IsmailAlrida/amb-processor/docs/report/report.tex

% !TEX root = C:\Users\Alrida Ismail\Documents\GitHub\amb-processor\docs\report\report.tex
\documentclass[12pt,a4paper]{article}

% ============================================================
% PREAMBLE
% ============================================================

% ---------------- Page Geometry ----------------
\usepackage[margin=1in,top=1.4in]{geometry}
\setlength{\headheight}{0.6in}
\setlength{\headsep}{0.3in}

% ---------------- Language ----------------
\usepackage[english]{babel}

% ---------------- Links ----------------
\usepackage[hidelinks]{hyperref}

% ---------------- Core ----------------
\usepackage{graphicx}
\graphicspath{{../../assets/}{./}}
\usepackage{fancyhdr}
\usepackage{xcolor}
\usepackage{titlesec}
\usepackage{float}

% ---------------- Math ----------------
\usepackage{amsmath, amssymb}
\usepackage{siunitx}

% ---------------- Tables ----------------
\usepackage{array, booktabs, tabularx, colortbl}
\newcolumntype{Y}{>{\raggedright\arraybackslash}X}

% ---------------- Code ----------------
\usepackage{listings}
\usepackage{tcolorbox}
\tcbuselibrary{breakable,skins}

\lstset{
    basicstyle=\ttfamily\small,
    breaklines=true,
    columns=fullflexible,
    frame=single
}

% ---------------- Colors ----------------
\definecolor{unired}{HTML}{EB5353}
\definecolor{uniblue}{HTML}{182C44}

% ---------------- Styled Boxes ----------------
\newtcolorbox{resultbox}[1][Key Result]{
    colback=blue!5,
    colframe=uniblue,
    fonttitle=\bfseries,
    title=#1,
    breakable
}

\newtcolorbox{warningbox}[1][Important]{
    colback=red!5,
    colframe=unired,
    fonttitle=\bfseries,
    title=#1,
    breakable
}

\newtcolorbox{tipbox}[1][Design Note]{
    colback=yellow!10,
    colframe=orange!80,
    fonttitle=\bfseries,
    title=#1,
    breakable
}

% ---------------- Header ----------------
\pagestyle{fancy}
\fancyhf{}
\fancyhead[L]{}
\fancyhead[C]{\textbf{\small ELEC 462}}
\fancyhead[R]{\textbf{\footnotesize College of Engineering}}
\fancyfoot[C]{\thepage}

\renewcommand{\headrulewidth}{1.5pt}
\renewcommand{\headrule}{\hbox to\headwidth{\color{unired}\leaders\hrule height \headrulewidth\hfill}}

% ---------------- Section Styling ----------------
\titleformat{\section}{\color{uniblue}\Large\bfseries}{\color{unired}\thesection}{1em}{}

% ============================================================
% TITLE PAGE
% ============================================================

\makeatletter
\renewcommand{\maketitle}{
\begin{titlepage}
\centering



\vspace{1cm}

{\Large United Arab Emirates University\par}
{\large College of Engineering\par}
{\large Department of Electrical Engineering\par}

\vspace{1.8cm}

{\Huge\bfseries\color{uniblue}The AMB Processor\par}
\vspace{0.4cm}
{\Large Implementation and RTL Design of the AMB Processor\par}
\vspace{0.3cm}
{\large Course Project -- Part 2\par}

\vspace{1.5cm}

{\large \textbf{Course:} ELEC 462 -- Computer Architecture and Organization\par}
\vspace{0.5cm}
{\large \textbf{Instructor:} Dr Abulhalim Jallad\par}

\vspace{1.5cm}

\begin{tabular}{|l|l|}
\hline
\textbf{Student Name} & \textbf{Student ID} \\ \hline
Alrida Ismail & 700040283 \\ \hline
Muddathir Yousif & 700039149 \\ \hline
Basel Alhomsi & 700036896 \\ \hline
\end{tabular}

\vfill

{\large \today\par}

\end{titlepage}
}
\makeatother

% ============================================================
\begin{document}
\maketitle

\begin{abstract}
This report presents the AMB processor as a single-cycle implementation of a custom 15-bit instruction set architecture (ISA) with 28-bit data words and byte-addressable memory. The project includes two implementation tracks. The first track preserves the original Part 1 ISA in Logisim artifacts, including the opcode decoder, hardwired control worksheet, and partial datapath. The second track implements the refined processor in Verilog, integrates it with instruction and data memory models, and verifies it through a Python-based assembler and RTL simulation workflow. The Verilog core successfully executes the required array-sum benchmark, producing the value 25 at data-memory address \texttt{0x0200}. The two tracks together show both the course-required control/datapath reasoning and the more regular RTL design that made the processor practical to assemble, simulate, inspect, and explain.
\end{abstract}

\section{ISA Summary}

The AMB processor was designed around a small fixed-length ISA: 15 instruction bits are stored in a 16-bit memory slot, while all architectural data values use 28 bits. Because memory is byte-addressable, every instruction occupies two consecutive bytes and the instruction counter (IC) advances by 2 during sequential execution. The assignment calls this state the program counter (PC); in this report, IC and PC refer to the same fetch address concept.

\begin{table}[H]
\centering
\caption{Core architectural parameters.}
\begin{tabularx}{\linewidth}{|l|Y|}
\hline
\textbf{Item} & \textbf{Value} \\ \hline
Instruction encoding width & 15 bits \\ \hline
Instruction storage width & 16 bits, with bit 15 unused \\ \hline
Data word width & 28 bits \\ \hline
Address width & 28 bits \\ \hline
Instruction memory model & Byte-addressed, two bytes per instruction \\ \hline
Data memory model & Byte-addressed, four bytes per 28-bit word transfer \\ \hline
Sequential IC update & \texttt{IC = IC + 2} \\ \hline
Execution model & Single-cycle fetch, decode, execute, memory, and writeback \\ \hline
\end{tabularx}
\end{table}

The original Part 1 ISA used three instruction formats: a 7-bit opcode register format, a 4-bit jump opcode with an 11-bit immediate, and a 3-bit immediate format. That design met the project constraints, but it forced the control unit to treat each instruction family differently. The refined RTL keeps the same 15-bit storage rule and 28-bit machine width, but regularizes decoding by making \texttt{instr[14:8]} a 7-bit opcode for every implemented instruction.

\begin{table}[H]
\centering
\caption{Implemented register map in the refined RTL path.}
\begin{tabularx}{\linewidth}{|c|l|Y|}
\hline
\textbf{Selector} & \textbf{Name} & \textbf{Role} \\ \hline
\texttt{0000}--\texttt{0111} & R0--R7 & General-purpose registers. \\ \hline
\texttt{1000} & IC (reserved name) & The fetch IC is dedicated CPU state in the RTL; it is exposed to instruction memory and testbenches rather than written as a normal register. \\ \hline
\texttt{1001} & SP & Reserved stack pointer slot. \\ \hline
\texttt{1010} & LC & Reserved loop counter slot. \\ \hline
\texttt{1011} & IMR & Immediate register used to assemble 28-bit constants from four 8-bit immediate-load instructions. \\ \hline
\texttt{1100} & JMPOFF & Base offset for long and conditional jumps. \\ \hline
\texttt{1101} & MEMOFF & Base offset for load/store effective addresses. \\ \hline
\texttt{1110} & CMPA & First operand for conditional branch comparisons. \\ \hline
\texttt{1111} & CMPB & Second operand for conditional branch comparisons. \\ \hline
\end{tabularx}
\end{table}

\begin{tipbox}[IC Implementation Note]
In the first ISA draft, IC appeared as a writable register-file entry. In the refined Verilog implementation, IC is dedicated CPU state. This keeps the fetch path under one synchronous owner while still exposing IC as an output for instruction memory and waveform inspection.
\end{tipbox}

\section{RTL And Logisim Overview}

The project is presented through two complementary implementation tracks. The main processor is the Verilog RTL core, where \texttt{cpu.v} connects instruction fetch, hardwired decode, the register file, the ALU, branch logic, and the external data-memory buses. Around that core, the Python application assembles AMB assembly programs, prepares memory images, launches Icarus Verilog simulation, and opens reports or waveforms. This toolchain is not the processor itself; it is the bench around the processor, and it makes the hardware behavior visible enough to debug.

The Logisim work preserves the original ISA direction requested by the assignment. It includes the opcode decoder, hardwired control-unit table, and partial datapath. That track is useful because it documents the direct course-style design process: signals are labeled, instruction classes are separated, and the control table follows the older instruction formats. The Verilog track then shows the same processor idea after the ISA was cleaned up into a more regular hardware contract.

\begin{resultbox}[Implemented Result]
The RTL simulation executes the mandatory array-sum benchmark for \texttt{N = 5} and array \texttt{[3, 7, 2, 9, 4]}. The recorded validation run halts after 65 cycles, with expected result \texttt{0x19} and actual result \texttt{0x19} at data-memory address \texttt{0x0200}.
\end{resultbox}

\section{ISA Optimization}

\subsection{What Changed}

The most important refinement was making the opcode field constant. In the implemented RTL, every instruction uses \texttt{instr[14:8]} as a 7-bit opcode. Register operations use \texttt{instr[7:4]} as \texttt{Rb} and \texttt{instr[3:0]} as \texttt{Ra}; immediate and jump operations reuse \texttt{instr[7:0]} as an 8-bit immediate. That single decision removes much of the old decoder branching and lets the controller classify operations by direct opcode comparison.

The second refinement was replacing partial destination-register immediate loads with an immediate assembly register, \texttt{IMR}. The processor now uses \texttt{LIL}, \texttt{LIH}, \texttt{LILL}, and \texttt{LIHH} to load four byte lanes of \texttt{IMR}. A normal \texttt{MOV} then transfers the assembled value into a general-purpose or special-purpose register. It takes a few simple instructions, but it avoids a larger immediate datapath and keeps the instruction format tidy.

Memory addressing also changed. The older ISA used \texttt{MEMOFF + imm8} for \texttt{LOAD} and \texttt{STOR}. The implemented RTL uses \texttt{MEMOFF + Rb}. This makes indexed memory access natural: a program can keep a pointer in a register, load or store through it, then increment the pointer using normal ALU instructions. The array-sum benchmark benefits directly from this choice. Table~\ref{tab:format_comparison} shows the encoding shift, while Tables~\ref{tab:old_isa_full} and~\ref{tab:new_isa_full} give the full old and new instruction sets.

\begin{table}[H]
\centering
\caption{Instruction-format change from the original ISA to the RTL-facing ISA.}
\begin{tabularx}{\linewidth}{|l|Y|Y|}
\hline
\textbf{Instruction Class} & \textbf{Original Part 1 Format} & \textbf{Refined RTL Format} \\ \hline
Register and system & \texttt{[14:8] opcode7, [7:4] Ra, [3:0] Rb} & \texttt{[14:8] opcode7, [7:4] Rb, [3:0] Ra} \\ \hline
Jump & \texttt{[14:11] opcode4, [10:0] imm11} & \texttt{[14:8] opcode7, [7:0] imm8} \\ \hline
Immediate and memory & \texttt{[14:12] opcode3, [11:8] Ra, [7:0] imm8} & \texttt{[14:8] opcode7, [7:0] imm8} for immediate loads; \texttt{[14:8] opcode7, [7:4] Rb, [3:0] Ra} for memory. \\ \hline
\end{tabularx}
\label{tab:format_comparison}
\end{table}

\begin{table}[H]
\centering
\small
\caption{Original Part 1 ISA retained for the Logisim compatibility track.}
\begin{tabularx}{\linewidth}{|l|l|l|Y|}
\hline
\textbf{Class} & \textbf{Opcode} & \textbf{Mnemonic} & \textbf{Behavior} \\ \hline
System & \texttt{0000000} & \texttt{HLT} & Halt CPU operation. \\ \hline
System & \texttt{0000001} & \texttt{NOP} & No architectural action. \\ \hline
Register & \texttt{0010000} & \texttt{NOT Ra} & Bitwise inverse of \texttt{Ra} is written to \texttt{Ra}. \\ \hline
Register & \texttt{0010001} & \texttt{OR Ra, Rb} & \texttt{Ra = Ra OR Rb}. \\ \hline
Register & \texttt{0010010} & \texttt{AND Ra, Rb} & \texttt{Ra = Ra AND Rb}. \\ \hline
Register & \texttt{0010011} & \texttt{XOR Ra, Rb} & \texttt{Ra = Ra XOR Rb}. \\ \hline
Register & \texttt{0010100} & \texttt{SHL Ra} & \texttt{Ra = Ra} $\ll$ \texttt{SHC}. \\ \hline
Register & \texttt{0010101} & \texttt{SHR Ra} & \texttt{Ra = Ra} $\gg$ \texttt{SHC}. \\ \hline
Register & \texttt{0010110} & \texttt{SAR Ra} & Arithmetic right shift of \texttt{Ra} by \texttt{SHC}. \\ \hline
Register & \texttt{0010111} & \texttt{ADD Ra, Rb} & \texttt{Ra = Ra + Rb}. \\ \hline
Register & \texttt{0011000} & \texttt{SUB Ra, Rb} & \texttt{Ra = Ra - Rb}. \\ \hline
Register & \texttt{0011001} & \texttt{MOV Ra, Rb} & \texttt{Ra = Rb}. \\ \hline
Jump & \texttt{0100} & \texttt{JMP imm11} & $\mathrm{IC} = \mathrm{IC} + (\mathrm{imm11} \ll 1)$. \\ \hline
Jump & \texttt{0101} & \texttt{JMPL imm11} & $\mathrm{IC} = \mathrm{IC} + (\mathrm{imm11} \ll 1) + \mathrm{JMPOFF}$. \\ \hline
Jump & \texttt{0110} & \texttt{JPEQ imm11} & If \texttt{CMPA == CMPB}, execute the long-jump update. \\ \hline
Jump & \texttt{0111} & \texttt{JPBLW imm11} & If \texttt{CMPA} $<$ \texttt{CMPB}, execute the long-jump update. \\ \hline
Immediate & \texttt{100} & \texttt{LIL Ra, imm8} & Set \texttt{Ra[7:0] = imm8}. \\ \hline
Immediate & \texttt{101} & \texttt{LIH Ra, imm8} & Set \texttt{Ra[15:8] = imm8}. \\ \hline
Immediate & \texttt{110} & \texttt{LOAD Ra, imm8} & \texttt{Ra = MEM[imm8 + MEMOFF]} as a 28-bit word. \\ \hline
Immediate & \texttt{111} & \texttt{STOR Ra, imm8} & \texttt{MEM[imm8 + MEMOFF] = Ra} as a 28-bit word. \\ \hline
\end{tabularx}
\label{tab:old_isa_full}
\end{table}

In the original register map, selector \texttt{1011} was \texttt{SHC}, the shift-count register used by \texttt{SHL}, \texttt{SHR}, and \texttt{SAR}. In the refined RTL map, that slot becomes \texttt{IMR}, and shifts use the normal \texttt{Rb} source register. That is a small ISA change, but it removes a special operand path from the ALU side of the datapath.

\begin{table}[H]
\centering
\small
\caption{Refined ISA implemented by the Verilog RTL.}
\begin{tabularx}{\linewidth}{|l|l|Y|}
\hline
\textbf{Opcode7} & \textbf{Mnemonic} & \textbf{Implemented Behavior} \\ \hline
\texttt{0000000} & \texttt{HLT} & Halt CPU operation and freeze state updates. \\ \hline
\texttt{0000001} & \texttt{NOP} & No architectural action; normal IC update still applies. \\ \hline
\texttt{0010000} & \texttt{NOT Ra} & Bitwise inverse of \texttt{Ra} is written to \texttt{Ra}. \\ \hline
\texttt{0010001} & \texttt{OR Ra, Rb} & \texttt{Ra = Ra OR Rb}. \\ \hline
\texttt{0010010} & \texttt{AND Ra, Rb} & \texttt{Ra = Ra AND Rb}. \\ \hline
\texttt{0010011} & \texttt{XOR Ra, Rb} & \texttt{Ra = Ra XOR Rb}. \\ \hline
\texttt{0010100} & \texttt{SHL Ra, Rb} & \texttt{Ra = Ra} $\ll$ \texttt{Rb}. \\ \hline
\texttt{0010101} & \texttt{SHR Ra, Rb} & \texttt{Ra = Ra} $\gg$ \texttt{Rb}. \\ \hline
\texttt{0010110} & \texttt{SAR Ra, Rb} & Arithmetic right shift of \texttt{Ra} by \texttt{Rb}. \\ \hline
\texttt{0010111} & \texttt{ADD Ra, Rb} & \texttt{Ra = Ra + Rb}. \\ \hline
\texttt{0011000} & \texttt{SUB Ra, Rb} & \texttt{Ra = Ra - Rb}. \\ \hline
\texttt{0011001} & \texttt{MOV Ra, Rb} & \texttt{Ra = Rb}. \\ \hline
\texttt{0011010} & \texttt{LIL imm8} & Set \texttt{IMR[7:0] = imm8}. \\ \hline
\texttt{0011011} & \texttt{LIH imm8} & Set \texttt{IMR[15:8] = imm8}. \\ \hline
\texttt{0011100} & \texttt{LILL imm8} & Set \texttt{IMR[23:16] = imm8}. \\ \hline
\texttt{0011101} & \texttt{LIHH imm8} & Set \texttt{IMR[27:24] = imm8[3:0]}. \\ \hline
\texttt{0011110} & \texttt{LOAD Ra, Rb} & \texttt{Ra = MEM[Rb + MEMOFF]} as a 28-bit word. \\ \hline
\texttt{0011111} & \texttt{STOR Ra, Rb} & \texttt{MEM[Rb + MEMOFF] = Ra} as a 28-bit word. \\ \hline
\texttt{1000000} & \texttt{JMP imm8} & $\mathrm{IC} = \mathrm{IC} + (\operatorname{signext}(\mathrm{imm8}) \ll 1)$. \\ \hline
\texttt{1000001} & \texttt{JMPL imm8} & $\mathrm{IC} = \mathrm{IC} + ((\operatorname{signext}(\mathrm{imm8}) + \mathrm{JMPOFF}) \ll 1)$. \\ \hline
\texttt{1000010} & \texttt{JPEQ imm8} & If \texttt{CMPA == CMPB}, execute the long-jump update. \\ \hline
\texttt{1000011} & \texttt{JPBLW imm8} & If \texttt{CMPA} $<$ \texttt{CMPB}, execute the long-jump update. \\ \hline
\end{tabularx}
\label{tab:new_isa_full}
\end{table}

\subsection{Why The Refinement Helped}

The original ISA was compact, but compactness came with control cost. A mixed opcode field means the control unit must first identify the instruction family and only then interpret the remaining bits. That is manageable on paper, but in a single-cycle datapath it quickly adds multiplexers, special cases, and decode paths that are easy to wire incorrectly.

The refined ISA trades a little encoding density for a cleaner datapath. With one opcode field, instruction classification becomes a direct comparison. With \texttt{IMR}, constant construction is explicit and easy to trace. With register-indexed memory, the benchmark loop can walk through an array using ordinary pointer arithmetic. In short, the new ISA is still small, but it gives the hardware fewer ways to get tangled.

\section{Datapath And RTL Development}

The Verilog processor is a single-cycle datapath. Instruction memory provides the current instruction combinationally from \texttt{IC}; the controller decodes \texttt{opcode}; the register file exposes \texttt{Ra} and \texttt{Rb}; the ALU produces arithmetic, logical, comparison, or address results; and the selected writeback value is committed on the next rising clock edge.

The instruction counter is one of the few explicitly synchronous elements in the core. On reset, \texttt{IC} becomes zero. When \texttt{halt} is not asserted, the next clock edge loads either \texttt{IC + 2} or the branch target:
\[
\mathrm{NextIC} = \mathrm{IC} +
\begin{cases}
(\operatorname{signext}(\mathrm{imm8}) + \mathrm{JMPOFF}) \ll 1, & \text{long or conditional jump taken} \\
\operatorname{signext}(\mathrm{imm8}) \ll 1, & \text{plain jump taken} \\
2, & \text{sequential execution.}
\end{cases}
\]
The left shift by one converts an instruction offset into a byte offset because each instruction occupies two bytes.

The register file uses asynchronous reads and synchronous writes. This is well suited to a single-cycle teaching processor: source operands are visible during the cycle, and the result lands in the destination register only at the clock edge. The same writeback port handles ALU results, memory loads, and immediate-byte writes into \texttt{IMR}. For \texttt{IMR}, the \texttt{ImmSel} control signal selects which byte lane is updated.

The data memory is byte-addressed but transfers 28-bit words. Reads are asynchronous and return four bytes assembled little-endian, with the upper nibble of the fourth byte used for bits 27--24. Stores are synchronous and split a 28-bit value back across four byte locations. This is why the benchmark uses a stride of 4 when iterating over the array.

\begin{table}[H]
\centering
\caption{Main datapath signals in the RTL core.}
\begin{tabularx}{\linewidth}{|l|Y|}
\hline
\textbf{Signal} & \textbf{Role} \\ \hline
\texttt{IC} & Byte address of the instruction currently being fetched. \\ \hline
\texttt{instr} & 16-bit stored instruction word; \texttt{instr[14:0]} is the ISA instruction. \\ \hline
\texttt{ReadDataRa}, \texttt{ReadDataRb} & Register-file outputs selected by the decoded instruction fields or by \texttt{CMPA}/\texttt{CMPB} during branches. \\ \hline
\texttt{OperandA}, \texttt{OperandB} & ALU operands; memory operations force \texttt{OperandA = MEMOFF}. \\ \hline
\texttt{ALURes} & Shared ALU output used for register writeback, data-memory address generation, and comparison side effects. \\ \hline
\texttt{DataAddress} & External data-memory address, directly driven by \texttt{ALURes}. \\ \hline
\texttt{RegDataWrite} & Final value written to the register file, selected from memory, ALU, immediate data, or zero. \\ \hline
\end{tabularx}
\end{table}

\section{Control Unit And Control Table}

The implemented controller is hardwired and combinational. It does not store microinstructions or step through states; each opcode directly produces the control signals needed for that cycle. This matches the single-cycle datapath: all control decisions are made before the clock edge that updates \texttt{IC}, the register file, and data memory.

\begin{table}[H]
\centering
\scriptsize
\caption{Verilog control table extracted from the implemented controller. \texttt{X} indicates a don't-care value because the destination path is disabled or unused.}
\resizebox{\linewidth}{!}{%
\begin{tabular}{lccccccccccccc}
\toprule
\textbf{Instr.} & \textbf{MemOp} & \textbf{RegWrite} & \textbf{ReadEn} & \textbf{WriteEn} & \textbf{isJump} & \textbf{LongJump} & \textbf{BrEq} & \textbf{BrLt} & \textbf{ImmLoad} & \textbf{RegDest} & \textbf{ImmSel} & \textbf{ALUCtrl} & \textbf{halt} \\
\midrule
\texttt{HLT}   & 0 & 0 & 0 & 0 & 0 & 0 & 0 & 0 & 0 & X  & X  & X    & 1 \\
\texttt{NOP}   & 0 & 0 & 0 & 0 & 0 & 0 & 0 & 0 & 0 & X  & X  & X    & 0 \\
\texttt{NOT}   & 0 & 1 & 0 & 0 & 0 & 0 & 0 & 0 & 0 & 01 & X  & 0000 & 0 \\
\texttt{OR}    & 0 & 1 & 0 & 0 & 0 & 0 & 0 & 0 & 0 & 01 & X  & 0001 & 0 \\
\texttt{AND}   & 0 & 1 & 0 & 0 & 0 & 0 & 0 & 0 & 0 & 01 & X  & 0010 & 0 \\
\texttt{XOR}   & 0 & 1 & 0 & 0 & 0 & 0 & 0 & 0 & 0 & 01 & X  & 0011 & 0 \\
\texttt{SHL}   & 0 & 1 & 0 & 0 & 0 & 0 & 0 & 0 & 0 & 01 & X  & 0100 & 0 \\
\texttt{SHR}   & 0 & 1 & 0 & 0 & 0 & 0 & 0 & 0 & 0 & 01 & X  & 0101 & 0 \\
\texttt{SAR}   & 0 & 1 & 0 & 0 & 0 & 0 & 0 & 0 & 0 & 01 & X  & 0110 & 0 \\
\texttt{ADD}   & 0 & 1 & 0 & 0 & 0 & 0 & 0 & 0 & 0 & 01 & X  & 0111 & 0 \\
\texttt{SUB}   & 0 & 1 & 0 & 0 & 0 & 0 & 0 & 0 & 0 & 01 & X  & 1000 & 0 \\
\texttt{MOV}   & 0 & 1 & 0 & 0 & 0 & 0 & 0 & 0 & 0 & 01 & X  & 1001 & 0 \\
\texttt{LIL}   & 0 & 1 & 0 & 0 & 0 & 0 & 0 & 0 & 1 & 10 & 00 & X    & 0 \\
\texttt{LIH}   & 0 & 1 & 0 & 0 & 0 & 0 & 0 & 0 & 1 & 10 & 01 & X    & 0 \\
\texttt{LILL}  & 0 & 1 & 0 & 0 & 0 & 0 & 0 & 0 & 1 & 10 & 10 & X    & 0 \\
\texttt{LIHH}  & 0 & 1 & 0 & 0 & 0 & 0 & 0 & 0 & 1 & 10 & 11 & X    & 0 \\
\texttt{LOAD}  & 1 & 1 & 1 & 0 & 0 & 0 & 0 & 0 & 0 & 00 & X  & 0111 & 0 \\
\texttt{STOR}  & 1 & 0 & 0 & 1 & 0 & 0 & 0 & 0 & 0 & X  & X  & 0111 & 0 \\
\texttt{JMP}   & 0 & 0 & 0 & 0 & 1 & 0 & 0 & 0 & 0 & X  & X  & X    & 0 \\
\texttt{JMPL}  & 0 & 0 & 0 & 0 & 1 & 1 & 0 & 0 & 0 & X  & X  & X    & 0 \\
\texttt{JPEQ}  & 0 & 0 & 0 & 0 & 1 & 1 & 1 & 0 & 0 & X  & X  & 1000 & 0 \\
\texttt{JPBLW} & 0 & 0 & 0 & 0 & 1 & 1 & 0 & 1 & 0 & X  & X  & 1000 & 0 \\
\bottomrule
\end{tabular}}
\label{tab:rtl_control}
\end{table}

\noindent The writeback selector is encoded as \texttt{RegDest = 00} for data memory, \texttt{01} for ALU result, and \texttt{10} for the zero-extended immediate byte. The \texttt{ImmSel} field selects the \texttt{IMR} byte lane: \texttt{00} for bits 7--0, \texttt{01} for bits 15--8, \texttt{10} for bits 23--16, and \texttt{11} for bits 27--24.

Branch control is deliberately explicit. For \texttt{JPEQ} and \texttt{JPBLW}, the CPU overrides the normal instruction register selects and reads \texttt{CMPA} and \texttt{CMPB}. The ALU continuously computes equality and unsigned less-than flags, and the branch unit selects the next IC only when the selected condition is true. This avoids hidden condition-code state and makes branch behavior easy to see in a waveform.

\section{Instruction Execution And Benchmark}

The mandatory benchmark sums five words from memory:
\[
3 + 7 + 2 + 9 + 4 = 25 = \texttt{0x19}.
\]
The data layout follows the assignment prompt: \texttt{LEN} is stored at \texttt{0x0100}, the array begins at \texttt{0x0104}, and the result is written to \texttt{0x0200}. Since each AMB data word occupies four bytes in the byte-addressed data memory, the loop increments the array pointer by 4 after every load. Listing~\ref{lst:array_sum_source} is the same benchmark source loaded by the app through its sample-code path.

\begin{lstlisting}[caption={Array-sum benchmark assembly source loaded by the app.},label={lst:array_sum_source}]
// Array sum benchmark
// N = 5
// ARRAY = [3, 7, 2, 9, 4]
// RESULT should become 25 at address 0x0200.

// R0 = sum
// R1 = LEN pointer
// R2 = len
// R3 = index
// R4 = 1
// R5 = 4-byte word stride
// R6 = array/result pointer
// R7 = current element

// Load LEN into R2
LIL 0x00
LIH 0x01
MOV R1, IMR
LOAD R2, R1

// Intialize sum and index registers as 0
LIL 0x00
LIH 0x00
MOV R0, IMR
MOV R3, IMR

// Set R4[0]
LIL 0x01
LIH 0x00
MOV R4, IMR

// R5 as 4 to use for striding 4-bytes in memory
LIL 0x04
LIH 0x00
MOV R5, IMR

// Load array start location to R6
LIL 0x04
LIH 0x01
MOV R6, IMR

// Loop across
loop:
MOV CMPA, R3
MOV CMPB, R2
JPBLW body
JMP done

// Loop while the index is less than the length
body:
LOAD R7, R6
ADD R0, R7

// Stride forward
ADD R6, R5

// Increment loop counter
ADD R3, R4

// Repeat
JMP loop

// Finish when index (R3) == len (R2)
done:
LIL 0x00
LIH 0x02
MOV R6, IMR
STOR R0, R6
HLT
\end{lstlisting}

The program first builds the required constants through \texttt{IMR}, then copies them into working registers. The loop uses \texttt{R0} as the running sum, \texttt{R2} as the length, \texttt{R3} as the index, \texttt{R5} as the four-byte stride, \texttt{R6} as the data pointer, and \texttt{R7} as the current element. Before each conditional branch, \texttt{R3} and \texttt{R2} are moved into \texttt{CMPA} and \texttt{CMPB}; \texttt{JPBLW} continues the loop while the index is below the length.

\begin{figure}[H]
\centering
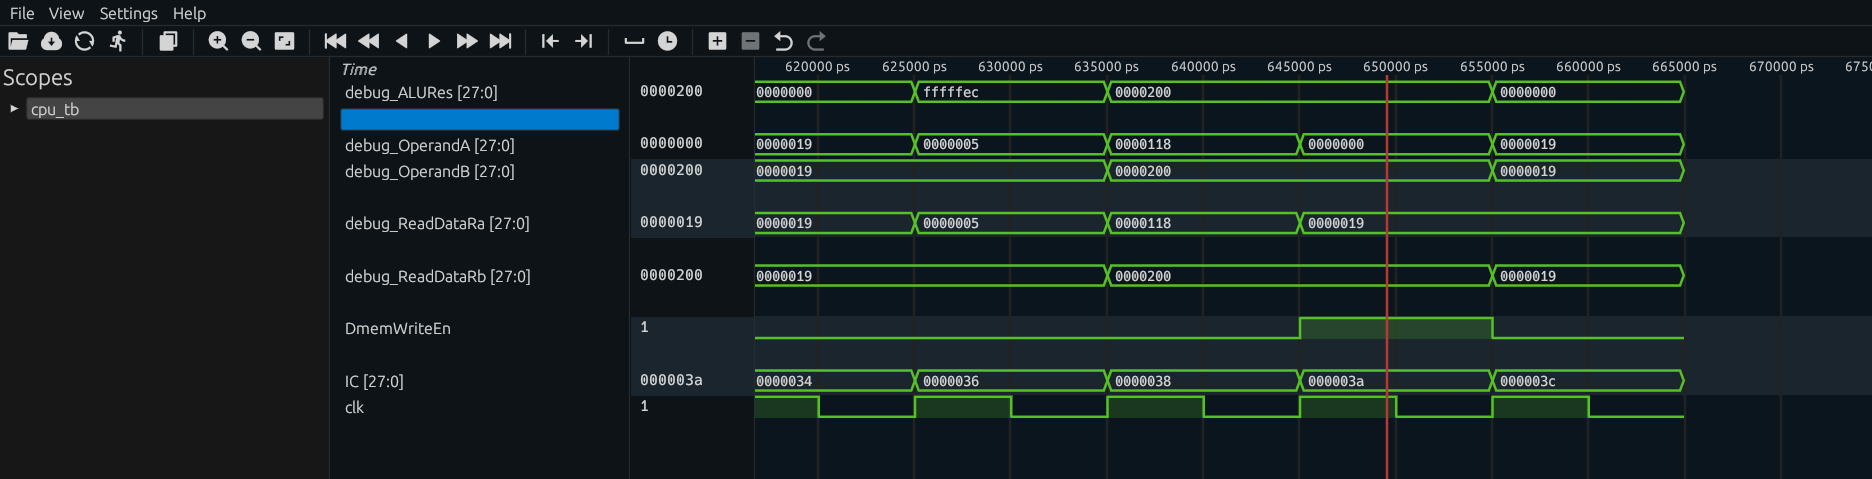
[picture p5: docs/report/writing0x19(Rb)to0x200(alures)dmem.png]

\caption{RTL waveform capture showing the final store of \texttt{0x19} to result address \texttt{0x0200}.}
\label{fig:rtl_result_waveform}
\end{figure}

Figure~\ref{fig:rtl_result_waveform} shows the final store transaction. In this cycle, \texttt{STOR R0, R6} uses \texttt{R0} as the value source and \texttt{R6} as the address source. Because \texttt{MEMOFF} is zero for this benchmark, the ALU address calculation is \texttt{0 + 0x0200}. The ALU result therefore drives \texttt{DataAddress = 0x0200}, while the data-memory write bus carries \texttt{0x19}. The value is committed only when \texttt{DmemWriteEn} is asserted.

\section{Integrated App Workflow}

The Python application exists to make the RTL processor easier to use, not to replace it. It provides an editor for AMB assembly, assembles source code into instruction-memory hex, prepares data-memory images, runs the Verilog testbench, and opens the generated result summary and waveform files. The app can be installed from the project \href{https://github.com/IsmailAlrida/amb-processor/releases/tag/latest}{GitHub releases page}.

To reproduce the benchmark, open the app, load the sample code, select the array-sum benchmark, and assemble the program. The sample also preloads the data memory with the required benchmark data, so the assembly program can focus on the processor behavior rather than manually constructing the array. After assembly, running the RTL simulation launches the Verilog testbench in the background and produces a report containing the final result, cycle count, halt status, and generated waveform artifacts.

For deeper inspection, the waveform viewer exposes the same internal signals used in this report: \texttt{IC}, \texttt{instr}, \texttt{opcode}, \texttt{RegWrite}, \texttt{RegDest}, data-memory enables, \texttt{DataAddress}, ALU operands, ALU result, comparison flags, and branch decisions. This gives the demonstration a useful split: the app shows that the program works, and the waveform shows why it works.

\section{Work-in-progress Logisim CPU}

The Logisim implementation follows the original Part 1 ISA and assignment-style control signals. Its purpose is to document the direct single-cycle datapath design requested in the project prompt: PC, instruction memory, register file, ALU, data memory, immediate unit, multiplexers, and hardwired control. The opcode decoder and control unit were built, while the full datapath remained a work in progress.

\begin{figure}[H]
\centering

\caption{Opcode decoder developed for the original Logisim ISA path.}
\label{fig:logisim_opcode_decoder}
\end{figure}

\begin{figure}[H]
\centering
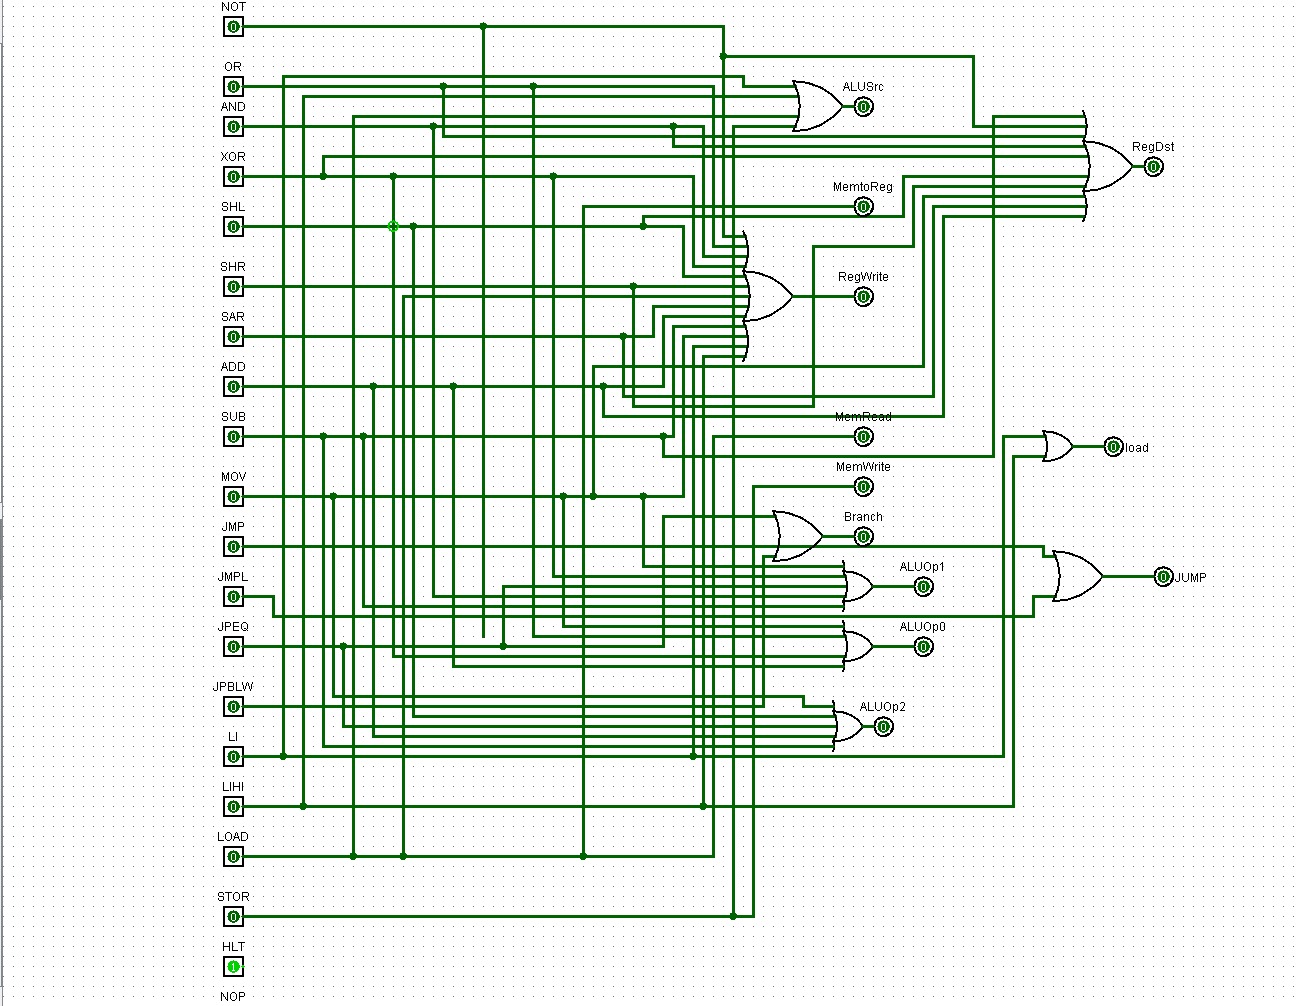
[picture p6: docs/report/logisim_control_unit.jpeg]

\caption{Logisim control-unit wiring for the original control signal set.}
\label{fig:logisim_control_unit}
\end{figure}

\begin{figure}[H]
\centering
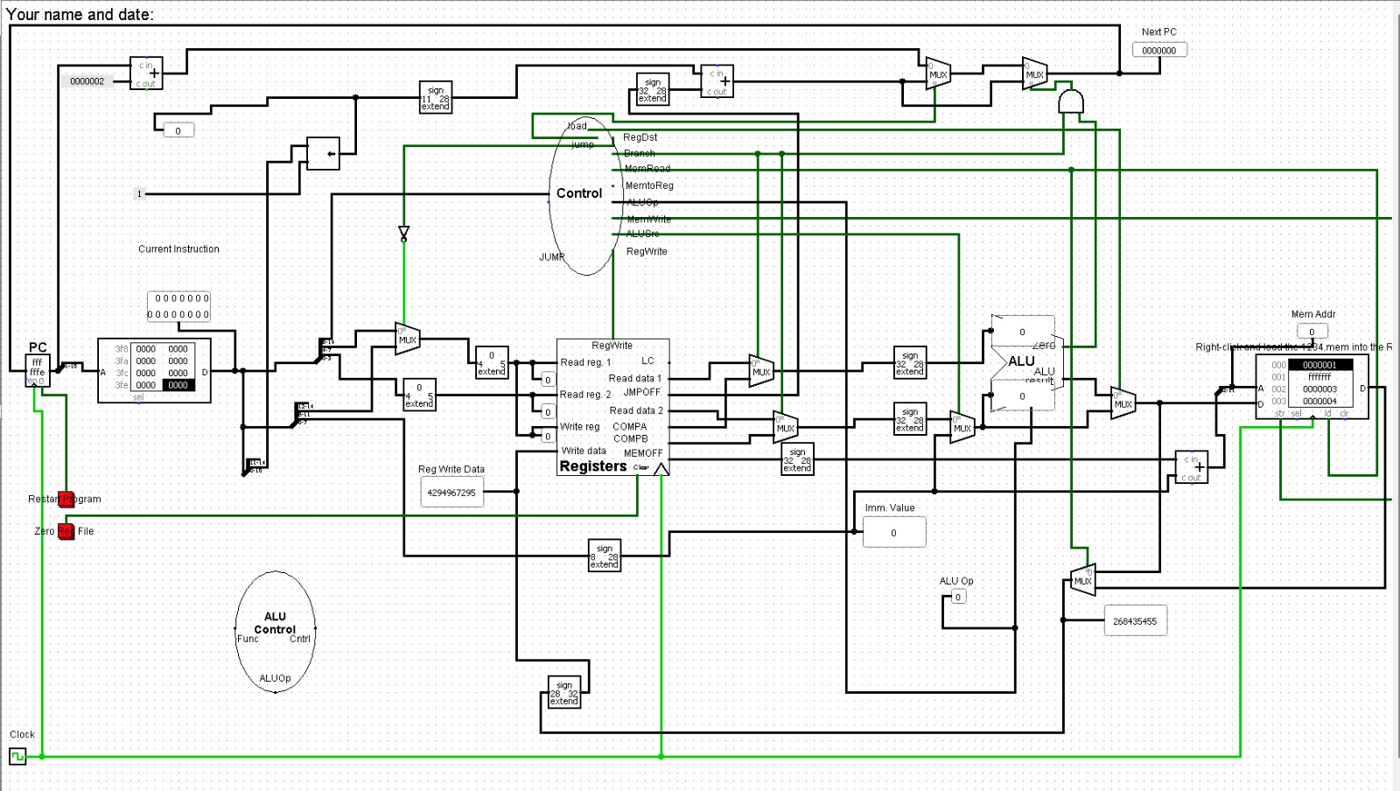
[picture p7: docs/report/partial-logisim-datapath.jpeg]

\caption{Partial Logisim datapath showing the course-required hardware construction direction.}
\label{fig:partial_logisim_datapath}
\end{figure}

The legacy control table used a compact control vocabulary: \texttt{RegWrite}, \texttt{MemRead}, \texttt{MemWrite}, \texttt{ALUSrc}, \texttt{Jump}, \texttt{Branch}, and \texttt{ALUOp}. This table is different from the Verilog controller in Table~\ref{tab:rtl_control}; it belongs to the original mixed-format ISA, where immediate and jump instructions required separate decoding rules.

\begin{table}[H]
\centering
\scriptsize
\caption{Legacy Logisim control-unit table transcribed from the control decoding worksheet.}
\resizebox{\linewidth}{!}{%
\begin{tabular}{llccccccc}
\toprule
\textbf{Instr.} & \textbf{Type} & \textbf{RegWrite} & \textbf{MemRead} & \textbf{MemWrite} & \textbf{ALUSrc} & \textbf{Jump} & \textbf{Branch} & \textbf{ALUOp} \\
\midrule
\texttt{ADD} & R & 1 & 0 & 0 & 0 & 0 & 0 & ADD \\
\texttt{SUB} & R & 1 & 0 & 0 & 0 & 0 & 0 & SUB \\
\texttt{AND} & R & 1 & 0 & 0 & 0 & 0 & 0 & AND \\
\texttt{OR}  & R & 1 & 0 & 0 & 0 & 0 & 0 & OR \\
\texttt{XOR} & R & 1 & 0 & 0 & 0 & 0 & 0 & XOR \\
\texttt{SHL} & R & 1 & 0 & 0 & 0 & 0 & 0 & SHL \\
\texttt{SHR} & R & 1 & 0 & 0 & 0 & 0 & 0 & SHR \\
\texttt{SAR} & R & 1 & 0 & 0 & 0 & 0 & 0 & SAR \\
\texttt{MOV} & R & 1 & 0 & 0 & 0 & 0 & 0 & PASS \\
\texttt{LIL} & I & 1 & 0 & 0 & 1 & 0 & 0 & LOAD\_IMM \\
\texttt{LIH} & I & 1 & 0 & 0 & 1 & 0 & 0 & LOAD\_IMM \\
\texttt{LOAD} & I & 1 & 1 & 0 & 1 & 0 & 0 & ADD \\
\texttt{STOR} & I & 0 & 0 & 1 & 1 & 0 & 0 & ADD \\
\texttt{JMP} & J & 0 & 0 & 0 & X & 1 & 0 & X \\
\texttt{JMPL} & J & 0 & 0 & 0 & X & 1 & 0 & X \\
\texttt{JPEQ} & J & 0 & 0 & 0 & X & 0 & 1 & CMP \\
\texttt{JPBLW} & J & 0 & 0 & 0 & X & 0 & 1 & CMP \\
\texttt{HLT} & SYS & 0 & 0 & 0 & X & 0 & 1 & X \\
\texttt{NOP} & SYS & 0 & 0 & 0 & X & 0 & 1 & X \\
\bottomrule
\end{tabular}}
\end{table}

The main implementation lesson from the Logisim path is that the original encoding made the wiring heavier than it needed to be. The revised RTL ISA removes that pressure by making opcode decoding regular, moving immediate assembly into \texttt{IMR}, and turning memory addressing into normal register-based pointer arithmetic.

\section{Reflection}

The AMB processor started as a compact custom ISA and became a working single-cycle RTL processor with an integrated assembler and simulation workflow. The completed Verilog design satisfies the core computer-architecture behavior expected from the project: instruction fetch, PC progression, register updates, ALU execution, memory load/store behavior, branching, halting, and benchmark execution.

The main limitation is that the Logisim implementation did not reach the same level of completion as the Verilog implementation. Still, the Logisim artifacts document the original control logic and show the required course-level datapath construction. The more complete result is the refined RTL processor: it is smaller to decode, easier to test, and much easier to explain from waveforms. That is the version we would carry forward for further ISA experiments, more benchmarks, and eventual synthesis-oriented cleanup.

\end{document}
