IsmailAlrida/amb-processor/docs/isa_v1/ISA.jpeg

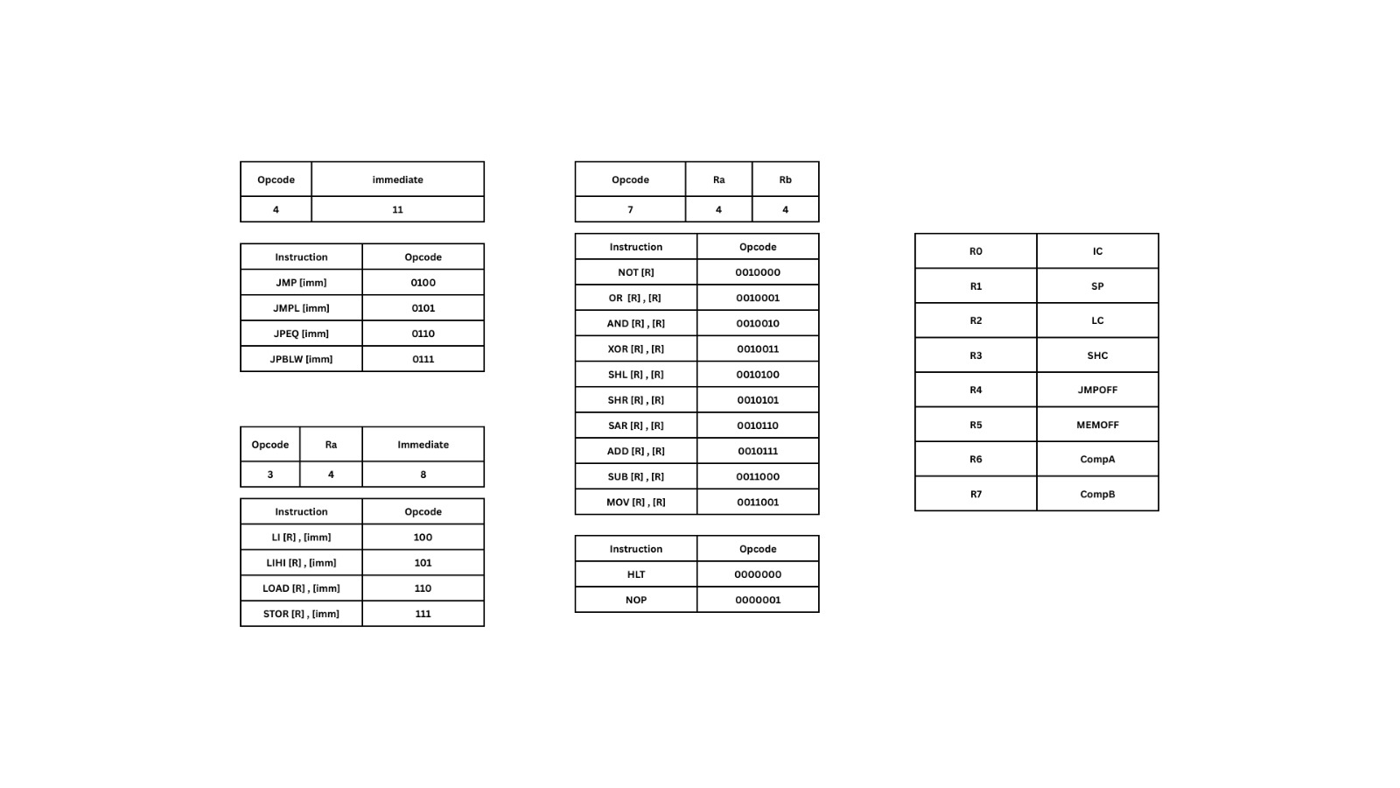
docs/isa_v1/ISA.jpeg
