IsmailAlrida/amb-processor/docs/report/opcode decoder.jpeg

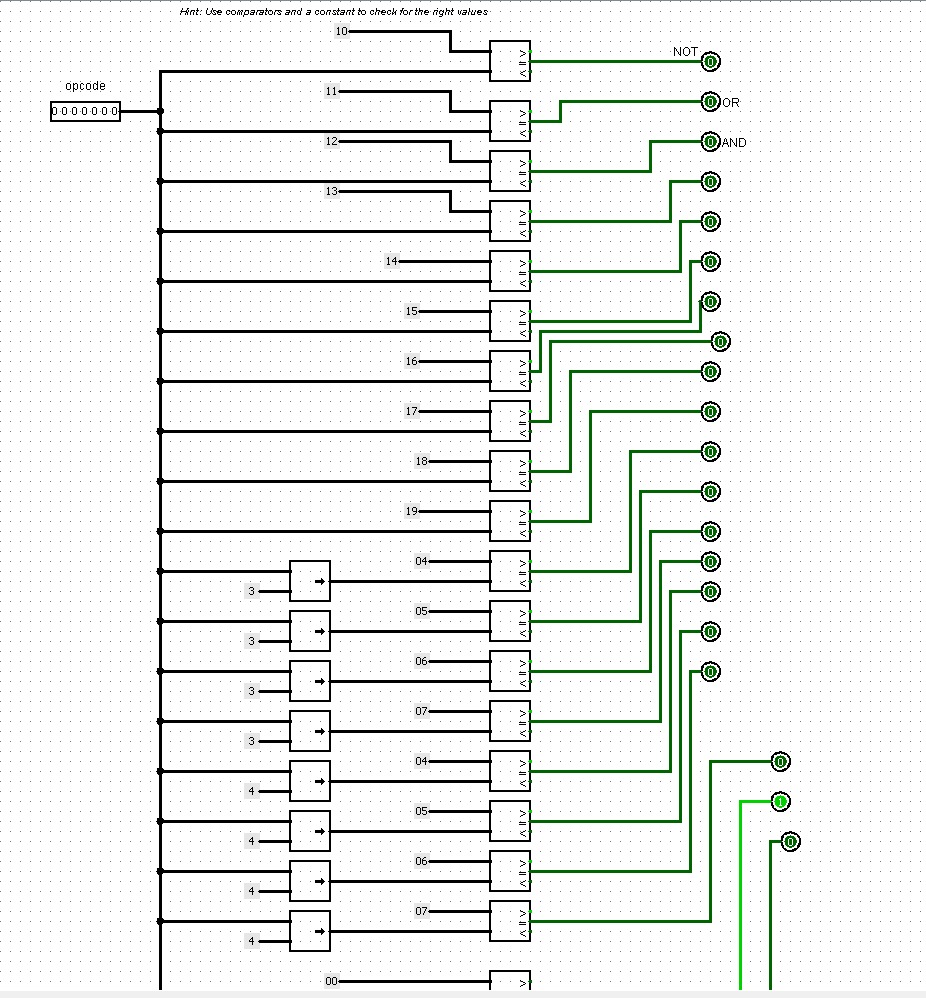
docs/report/opcode decoder.jpeg
