IsmailAlrida/amb-processor/docs/cpu_components/alu.md

# Entity: alu 
- **File**: alu.v

## Diagram
Diagram
## Description

Combinational arithmetic logic unit for ISA v1 register operations, moves, shifts, and comparisons.

## Generics

| Generic name | Type | Value | Description |
| --- | ---- | ----- | --- |
| DATA_WORD_WIDTH  | | 28 | Width of each ALU operand and result word. |
| CONTROL_OP_WIDTH | | 4 | Width of the ALU operation selector. |

## Ports

| Port name | Direction | Type | Description |
| --- | --- | --- | --- |
| clk | input | | Clock carried for module contract symmetry with the CPU datapath. |
| reset | input | | Reset carried for module contract symmetry with the CPU datapath. |
| halt | input | | Halt carried for module contract symmetry with the CPU datapath. |
| OperandA  | input | [DATA_WORD_WIDTH-1:0]  | First ALU operand, normally Ra data or MEMOFF during memory address calculation. |
| OperandB  | input | [DATA_WORD_WIDTH-1:0]  | Second ALU operand, normally Rb/source data. |
| ALUCtrl | input | [CONTROL_OP_WIDTH-1:0] | Operation selector generated by the controller. |
| result | output | [DATA_WORD_WIDTH-1:0]  | Combinational result for the selected ALU operation. |
| zero | output | | Equality flag asserted when OperandA equals OperandB. |
| altb | output | | Unsigned less-than flag asserted when OperandA is below OperandB. |

## Constants

| Name | Type | Value | Description |
| --- | ---- | --- | --- |
| ALU_NOT | | 4'b0000 | Operation code for bitwise inversion. |
| ALU_OR  | | 4'b0001 | Operation code for bitwise OR. |
| ALU_AND | | 4'b0010 | Operation code for bitwise AND. |
| ALU_XOR | | 4'b0011 | Operation code for bitwise XOR. |
| ALU_SHL | | 4'b0100 | Operation code for logical left shift. |
| ALU_SHR | | 4'b0101 | Operation code for logical right shift. |
| ALU_SAR | | 4'b0110 | Operation code for arithmetic right shift. |
| ALU_ADD | | 4'b0111 | Operation code for addition. |
| ALU_SUB | | 4'b1000 | Operation code for subtraction. |
| ALU_MOV | | 4'b1001 | Operation code for MOV, forwarding OperandB. |

## Processes
- operation_select: ( @(*) )
  - **Type:** always
  - **Description**
  Computes the selected ALU operation and updates comparison flags.
