IsmailAlrida/amb-processor/docs/isa_pentest_report.md

# AMB ISA Pen-Test Review (Legal but Dangerous Behaviors)

Scope:
- `src/assembler/isa.py`
- `src/assembler/cpu.py`
- `docs/ISA.md`

Date:
- 2026-02-17

## Executive Summary

The current ISA and simulator allow multiple high-impact behaviors that are fully legal under the spec but unsafe for reliable programs: overlapping word stores, wrap-around memory writes, and direct self-modifying code. These are not Python crashes; they are architectural hazards that can silently corrupt code and data.

## Findings

### [CRIT-01] Unaligned/Overlapping word stores are legal and corrupt neighboring data

Evidence:
- `STOR` computes byte address directly: `addr = (imm8 + MEMOFF) & ADDR_MASK` in `src/assembler/cpu.py:147`.
- Word store writes 4 bytes at `addr..addr+3`: `src/assembler/cpu.py:80`.
- ISA doc defines byte-addressable offset addition but does not require 4-byte alignment: `docs/ISA.md:87`, `docs/ISA.md:91`.

Impact:
- Incrementing pointers by 1 while using `STOR` creates overlapping writes and corrupts adjacent values (especially strings/byte buffers and packed structs).

### [CRIT-02] No code/data separation allows legal self-modifying code

Evidence:
- Program instructions and data share one memory space (`load_program` writes into same memory object): `src/assembler/cpu.py:113`.
- `STOR` can target any effective address with no execute/write protection: `src/assembler/cpu.py:147`.

Impact:
- Any program can overwrite its own instructions or future instructions at runtime, intentionally or accidentally.

### [HIGH-01] Address wrap-around on writes can clobber low memory

Evidence:
- All memory accesses are masked with `ADDR_MASK`: `src/assembler/cpu.py:49`, `src/assembler/cpu.py:81`.
- Byte writes for word stores use `(addr + 1/2/3) & ADDR_MASK`: `src/assembler/cpu.py:88`, `src/assembler/cpu.py:89`, `src/assembler/cpu.py:90`.

Impact:
- Writes near the top of memory wrap into address 0 and can silently corrupt low memory/code.

### [HIGH-02] ISA doc/implementation mismatch for `NOP` opcode

Evidence:
- Implementation: `NOP = 0b0000001` in `src/assembler/isa.py:70`.
- Documentation currently lists `NOP` as `000 0000` (same as `HLT`) in `docs/ISA.md:50`, `docs/ISA.md:51`.

Impact:
- Hardware/software mismatch risk and impossible-to-debug behavior if teams implement from the markdown table alone.

### [MED-01] Endianness is mixed/unspecified between instruction and data words

Evidence:
- Instruction fetch (`read_word`) treats byte at lower address as high byte: `src/assembler/cpu.py:59`.
- Data `read_word28`/`write_word28` use little-endian byte layout: `src/assembler/cpu.py:72`, `src/assembler/cpu.py:80`.
- ISA markdown does not clearly define this difference.

Impact:
- Interop and debugging confusion; raw memory inspection can be misread.

### [MED-02] Signed/unsigned immediate aliasing is legal and ambiguous

Evidence:
- IMM accepts `-128..255` and encodes `imm8 & 0xFF`: `src/assembler/assembler.py:202`, `src/assembler/assembler.py:204`.

Impact:
- Different literals map to same encoding (`-1 == 255` in machine code), which can mislead tooling and reviewers.

### [MED-03] Conditional-branch compare semantics are underspecified in markdown

Evidence:
- CPU uses unsigned compare for `JPBLW`: `src/assembler/cpu.py:176`.
- ISA markdown says “below” but does not explicitly state unsigned ordering: `docs/ISA.md:69`, `docs/ISA.md:71`.

Impact:
- Signed expectations in user code can produce silently wrong control flow.

## Proof-of-Concept Behaviors Observed

1. Overlap corruption:
- Repeated `STOR` with `MEMOFF += 1` produced sliding 4-byte writes where each write overwrote 3 bytes from previous write.

2. Self-modifying code:
- Program storing to address `0x0000000` changed bytes of initial instructions and then continued execution.

3. Wrap-around write:
- Setting `MEMOFF` near `ADDR_MASK` and executing `STOR` wrote bytes at the end of memory and wrapped into low addresses.

## Recommended ISA Refinements (Priority Order)

1. Enforce alignment for word ops (or trap):
- Define `LOAD/STOR` as requiring `effective_addr % 4 == 0`.
- If misaligned: define deterministic fault/trap behavior.

2. Split byte and word memory ops:
- Keep `LOADW/STORW` for aligned 28-bit words.
- Add `LDB/STB` for byte-granular access (string-safe operations).

3. Define memory regions:
- At minimum specify code region as non-writable during execution (or state explicitly that self-modifying code is allowed, with warnings).

4. Clarify wrapping semantics:
- Either forbid address wrap for multi-byte ops, or explicitly define and document wrap behavior as intentional.

5. Fix spec mismatch immediately:
- Update `NOP` opcode in `docs/ISA.md` to match implementation (`000 0001`).

6. Specify endianness explicitly:
- State instruction-endianness and data-word endianness in ISA docs.

7. Clarify signedness:
- State `JPBLW` is unsigned compare.
- State IMM encoding canonical representation recommendations (e.g., prefer `0..255` literals for imm8).

## Optional Tooling Guardrails (Assembler/UI)

1. Lint warning: `STOR/LOAD` to unaligned addresses.
2. Lint warning: `STOR` target overlaps code address range.
3. Lint warning: `MEMOFF` increments by non-word stride in loops using `STOR`.
