IsmailAlrida/amb-processor/(list of files, drawings)

Other design files:
src/Logisim/AMB.circ
src/Logisim/mips/mips.circ
