IsmailAlrida/amb-processor/src/kicad/amb_processor/amb_processor.kicad_sch

## KiCad design src/kicad/amb_processor/amb_processor.kicad_sch (2026-04-27)

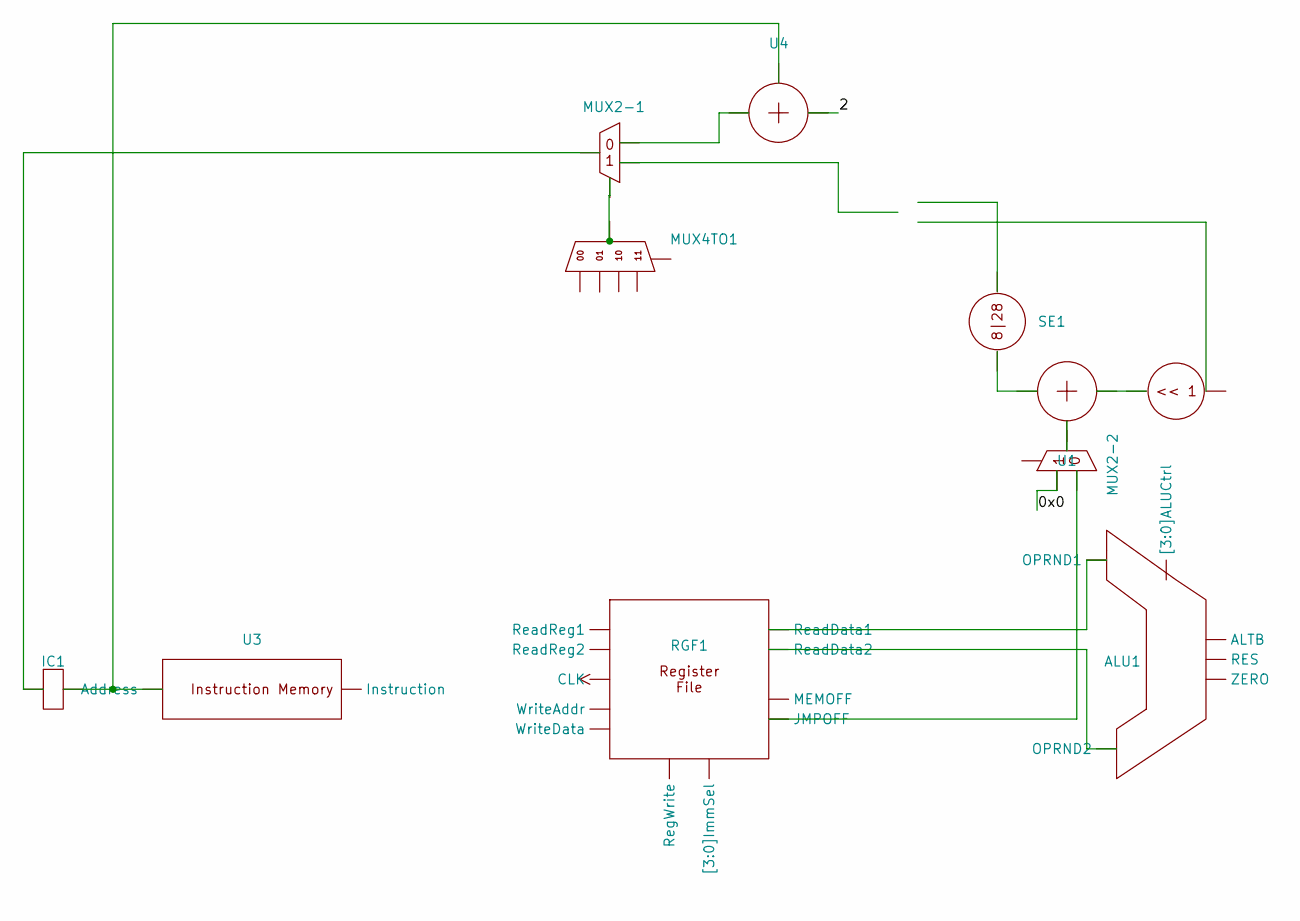
[picture p10: schematic amb_processor.kicad_sch]

Parts:
ALU1: (no value)
IC1: (no value)
MUX2-1, MUX2-2, MUX4TO1: (no value)
RGF1: (no value)
SE1: (no value)
U1, U2, U3, U4: (no value)

Connections:
0x0: MUX2-2.
2: U4.
unnamed: ALU1., RGF1.
unnamed: IC1., MUX2-1., U3., U4.
unnamed: MUX2-1., MUX4TO1., U4.
unnamed: MUX2-2., RGF1., U1.
unnamed: SE1., U1.
unnamed: U1., U2.
