IsmailAlrida/amb-processor/(commit log)

2026-02-16 sample code and comment greying
2026-02-16 button recolor
2026-04-26 Updated assembler to match new ISA
2026-04-26 added flag handling + bug fix
    [alu.v]
2026-04-26 Bug fixes all over
    [alu.v, control_unit.v, reg_file.v]
2026-04-27 [fix] normalize oss cad suite path resolution
    [run_rtl_sim.py]
2026-04-27 fixed windows problem with paths or somethin
    [run_rtl_sim.py]
2026-06-04 first silicon run
    [amb_processor.kicad_pcb, amb_processor.kicad_sch, cpu__max_ff_n40C_1v95.sdf, cpu__max_ss_100C_1v60.sdf, cpu__max_tt_025C_1v80.sdf, cpu__min_ff_n40C_1v95.sdf, cpu__min_ss_100C_1v60.sdf, cpu__min_tt_025C_1v80.sdf]
2026-06-04 cut debug wires + cicd fix mac/windows
    [run_rtl_sim.py, tb.v]
2026-06-05 polishing UI, docs, and smoke fix
    [run_rtl_sim.py]
2026-06-05 more ui polish and cicd fix for mac
    [run_rtl_sim.py]
2026-06-05 stage hex file inputs before readmemh
